Guiiem/TFG/01-Latex/Report/Glossary_file.tex

\glsxtrnewsymbol[description={Axial induction factor },unit={-}]{a}{$a$}
\glsxtrnewsymbol[description={Tangencial induction factor },unit={-}]{ap}{$a'$}
\glsxtrnewsymbol[description={Sectional drag coefficient},unit={-}]{Cd}{$C_d$}
\glsxtrnewsymbol[description={Sectional lift coefficient},unit={-}]{Cl}{$C_l$}
\glsxtrnewsymbol[description={Power coefficient},unit={-}]{Cp}{$C_P$}
\glsxtrnewsymbol[description={Torque coefficient},unit={-}]{Cq}{$C_Q$}
\glsxtrnewsymbol[description={Thrust coefficient},unit={-}]{Ct}{$C_T$}
\glsxtrnewsymbol[description={Coefficient of sectional blade element force normal to the rotor plane},unit={-}]{Cx}{$C_x$}
\glsxtrnewsymbol[description={Coefficient of sectional blade element force parallel to the rotor plane},unit={-}]{Cy}{$C_y$}
\glsxtrnewsymbol[description={Torque},unit={\si{\newton \meter}}]{Q}{\ensuremath{Q}}
\glsxtrnewsymbol[description={Local radius of the blades},unit={\si{\meter}}]{r}{\ensuremath{r}}
\glsxtrnewsymbol[description={Total radius of the blades},unit={\si{\meter}}]{R}{\ensuremath{R}}
\glsxtrnewsymbol[description={Wind speed},unit={\si{\meter \per \second}}]{Uinf}{$U_{\infty}$}

\glsxtrnewsymbol[description={},unit={ }]{Blank}{ }

\glsxtrnewsymbol[description={Angle of attack},unit={rad}]{Alpha}{$\alpha$}
\glsxtrnewsymbol[description={Angle of attack - optimal},unit={rad}]{AlphaOpt}{$\alpha_{opt}$}
\glsxtrnewsymbol[description={Angle of attack - stall},unit={rad}]{AlphaStall}{$\alpha_{s}$}

\glsxtrnewsymbol[description={Geometric twist plus pitch offset of the blades},unit={rad}]{beta}{$\beta$}

\glsxtrnewsymbol[description={Tip speed ratio},unit={-}]{Lambda}{$\lambda$}
\glsxtrnewsymbol[description={Tip speed ratio - local},unit={-}]{LambdaR}{$\lambda_r$}

\glsxtrnewsymbol[description={Air density},unit={\si{\kg \per \meter \cubed}}]{rho}{$\rho$}

\glsxtrnewsymbol[description={Local blade solidity},unit={-}]{bladesol}{$\sigma_r$}

\glsxtrnewsymbol[description={Adimensional local radius of the blades $r/R$},unit={-}]{Mu}{$\mu$}

\glsxtrnewsymbol[description={Geometric twist of the blades},unit={rad}]{tau}{$\tau$}

\glsxtrnewsymbol[description={Flow angle},unit={rad}]{phi}{$\phi$}

\glsxtrnewsymbol[description={Rotor speed},unit={\si{\radian \per \second}}]{Omega}{$\Omega$}

%\glsxtrnewsymbol[description={velocity},unit={\si{\metre\per\second}}]{v}{\ensuremath{v}}
%\glsxtrnewsymbol[description={acceleration},unit={\si{\metre\per\second\squared}}]{a}{\ensuremath{a}}
%\glsxtrnewsymbol[description={time},unit={\si{s}}]{t}{\ensuremath{t}}
%\glsxtrnewsymbol[description={force},unit={\si{N}}]{F}{\ensuremath{F}}
%\glsxtrnewsymbol[description={forasdasdasdce},unit={\si{N}}]{R}{\ensuremath{X_R}}

%ABCDEFGHIJKLMNOPQRSTUVWXYZ
