Guiiem/TFG/01-Latex/Report/TFG_Report.tex

\documentclass[11pt, a4paper, twoside]{book}

\usepackage[utf8]{inputenc}
\usepackage[T1]{fontenc} %Accents automàtics
\usepackage[english]{babel} %Language of the text
\usepackage[table]{xcolor}
\definecolor{lightgray}{gray}{0.9}
%Import the format package
\usepackage{Format}
\usepackage{placeins}
\usepackage{multirow}
\setcounter{secnumdepth}{5} %Level of depth in the numbering
\setcounter{tocdepth}{5}
\usepackage{xr}
\externaldocument{../Report_Attachment/TFG_Annex}

\usepackage[center]{caption}

\setlength\headheight{42pt} 

\setlength{\parindent}{0em}

\usepackage{pdflscape}
\usepackage{graphicx}
\usepackage{longtable}
\usepackage{adjustbox}

\usepackage{array}
\newcolumntype{L}[1]{>{\raggedright\let\newline\\\arraybackslash\hspace{0pt}}m{#1}}
\newcolumntype{C}[1]{>{\centering\let\newline\\\arraybackslash\hspace{0pt}}m{#1}}
\newcolumntype{R}[1]{>{\raggedleft\let\newline\\\arraybackslash\hspace{0pt}}m{#1}}

%% Headers in all the pagines
%% https://www.overleaf.com/learn/latex/Headers_and_footers
\usepackage{fancyhdr}
\pagestyle{fancy}
\renewcommand{\sectionmark}[1]{\markright{#1}}
\fancyhf{}
\rhead{\fancyplain{}\rightmark} %\Thesection?
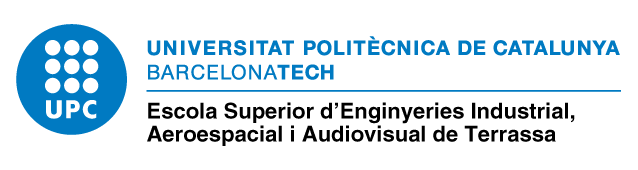
[picture p1: 01-Latex/Report/Logo_escola.png]
\lhead{} %Title?
\cfoot{\thepage}

\title{Glory template}
\author{Guillem Vergés i Plaza }
\date{October 2018}

\usepackage{afterpage}

\newcommand\blankpage{%
	\null
	\thispagestyle{empty}%
	\addtocounter{page}{-1}%
	\newpage}

\let\cleardoublepage=\clearpage

\usepackage{subfiles}

\usepackage{hyperref}
\usepackage{array}

\usepackage{svg}

\usepackage{siunitx}

%%\usepackage[colorlinks]{hyperref}
%\usepackage{glossaries-extra}
\usepackage[symbols,nogroupskip]{glossaries-extra}

% new keys must be defined before use

\glsaddstoragekey{unit}{}{\glsentryunit}
\glsnoexpandfields

\loadglsentries{Glossary_file}

\newglossarystyle{symbunitlong}{%
	\setglossarystyle{long3col}% base this style on the list style
	\renewenvironment{theglossary}{% Change the table type --> 3 columns
		\begin{longtable}{cp{\glsdescwidth}>{\centering\arraybackslash}p{2cm}}}%
		{\end{longtable}}%
	
	\renewcommand*{\glossaryheader}{%  Change the table header
		\bfseries Symbol & \bfseries Description & \bfseries Unit\\\hline
		\endhead}%
	\renewcommand*{\glossentry}[2]{%  Change the displayed items
		\glstarget{##1}{\glossentryname{##1}} %
		& \glossentrydesc{##1}% Description
		& \glsentryunit{##1}  \tabularnewline
	}%
}

\begin{document}

%%PORTADA---------------------------------------------------

\begin{titlepage}
\newcommand{\HRule}{\rule{\linewidth}{0.5mm}}
\center
\\[2cm]

\textsc{\Large Bachelor's Degree in Aerospace Technology Engineering}\\[0.5cm]
\textsc{\large Bachelor Thesis - Document: REPORT}\\[0.5cm]
\HRule \\[0.4cm]
{\Large \bfseries Project of designing and manufacturing a small wind turbine using fused deposition modeling technology }\\[0.1cm]
\HRule \\[2cm]
\large \emph{Director:}\\[0.5cm] 
%Table with the surnames alligned if necessary
Francesc Xavier \textsc{Sanz Cano}\\
[1cm]
\large \emph{Co-Director:}\\[0.5cm] 
%Table with the surnames alligned if necessary
Álvaro \textsc{Luna Alloza}\\
[1.5cm]
\large \emph{Autor:}\\[0.5cm] 
%Table with the surnames alligned if necessary
Guillem \textsc{Vergés i Plaza}\\
[1cm]
\vfill

\afterpage{\blankpage}

\begin{minipage}{0.4\textwidth}
\begin{flushleft} \large
\emph{Delivery date:}\\[0.2cm] 00-00-0000
\end{flushleft}
\end{minipage}
\begin{minipage}{0.4\textwidth}
\begin{flushright} \large
\emph{Presentation date:}\\[0.2cm] 28-10-2018
\end{flushright}
\end{minipage}
\end{titlepage}

%Define the size the pages will have
\newgeometry{inner=25mm,outer=25mm,top=35mm,bottom=30mm}

\section*{Abstract}

\newpage

\section*{Declaration of honour}

\newpage

\pagenumbering{arabic}

\tableofcontents
\listoffigures
\listoftables
\newpage

\printunsrtglossary[type=symbols,style=symbunitlong]

\chapter{Introduction}

	\section{Aim}
	
	\section{Scope}
	
	\section{Requirements}
	
	\section{Justification of the need}

\chapter{Development}

	\section{Background and review of the state of the art}
	
	\subfile{Development/State_of_the_art}
	
	\section{Approach and decision on possible solutions}
	\subfile{Development/Conceptual_design}

	\newpage
	\section{Electric design}
	\subfile{Development/ElectricDesign}

	\newpage
	\section{Aerodynamic design}
	\subfile{Development/AerodynamicDesign}
	
	\section{Structural design}
	\subfile{Development/StructuralDesign}

\chapter{Summary of the results}

\section{Budget summary}

\section{Analysis and assessment of the environmental implications}

\section{Future lines of work}

\section{Planning and programming of the next stage}

\section{Conclusions}

\bibliographystyle{ieeetran}
\raggedleft
\bibliography{TFG_Bibliography}

\end{document}
