Guiiem/TFG/01-Latex/Report/Development/StructuralDesign.tex

\documentclass[../TFG_Report.tex]{subfiles}
 
\begin{document}
	
\subsection{3D printing previous considerations}

\subsubsection{Printer characteristics}\label{Section_printer_character}

\subsubsection{Filament selection}

\subsection{Load cases}

\subsection{Link design and printing properties}

\end{document}
