Guiiem/TFG/06-Blade design/Aero/Iterations.ods

Iteration Number | 1st
Parameters
Individual members | 2000
Generations | 100
Crossover probability | 0.1
Maximum age | 20
Airfoil | 9-S1223
Reynolds | 3 | 120_200
Alpha | 50 | -12.5_12.5
Delta_alpha | 0.5
Airfoil cross section/c^2 | 0.0660 | Mesurat solidworks
Blade density | 430 | Estimat amb Cura
Blade elements per blade | 15
U cut in | 4
U rated | 10
TSR end starting | 4.608 | El optim directament
Min CP | 0 | pq min?
Maxim T starting | 200 | Default
TSR opt | 4.608 | Calculat
Radius | 0.8 | Calculat
Hub radius/r_tip | 0.38 | Hub de 30cm
Max chord | 1m | No limit
Min chord | 0 | No limit
Max twist | 90 | No limit
Min twist | -90 | No limit
J_gen | 0.006 | Dades gen
Resistive torque gen | 0
Factor to scale fitness for power | 0.7 | Default
Index of non dimnated blades | 1m | Default
Index of unfit blades | 1m | Default
Index on dominated blades | 2 | Default
Number of non dominated blades | 0 | Default
Number of unfit blades | 0 | Default
Number of dominated blades | 0 | Default
