Guiiem/TFG/06-Blade design/Aero/Power_curve_procedure_image.pdf

PMG selection | Airfoil selection | Blade geometry definition

[Not supported by viewer] [Not supported by viewer] [Not supported by viewer]

| Polars in 360º AoA range

Viterna extrapolation

Airfoil selection

[Not supported by viewer]

Blade Element Momentum Theory [Not supported by viewer]

ot supported by viewer]

[Not supported by viewer]

Intersection of both curves

Power curve<br>P = f(U)

[Not supported by viewer]

[Not supported by viewer]

[Not supported by viewer] [Not supported by viewe [Not supported by viewer] [Not supported by viewe [Not supported by viewer] [Not supported by viewe [Not supported by viewer] [Not supported by viewe [Not supported by viewer] [Not supported by viewe [Not supported by viewer] [Not supported by viewe [Not supported by viewer] [Not supported by viewe

[Not supported by viewer]

[Not supported by viewer]

[Not supported by viewer]

[Not supported by viewer]
