Guiiem/TFG/01-Latex/Report/Images/Aerodynamic_Design/First_AngleOfAttack_Analysis-eps-converted-to.pdf

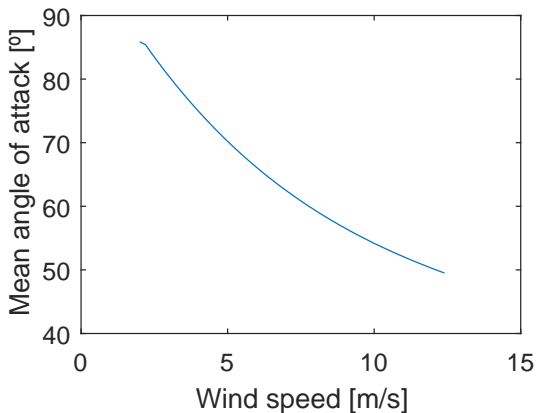
[picture p17: figure]
Wind speed [m/s]; Mean angle of attack [º]
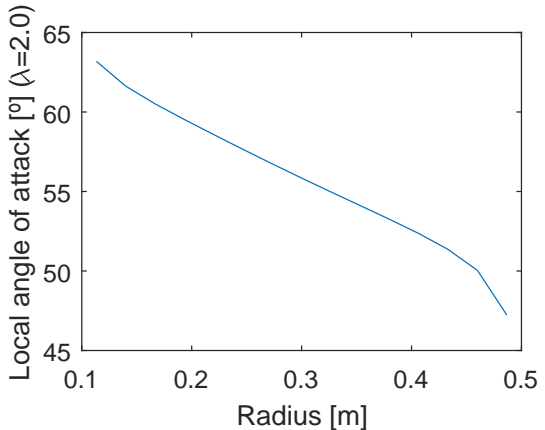
[picture p18: figure]
Radius [m]; Local angle of attack [º] ( =2.0)
