Guiiem/TFG/06-Blade design/Aero/1st iteration/SWT_Code/Read_Me_First.pdf

Running the Blade Optimisation programs

The m-file blade_opt_setup.m is configured to produce the data structure called ”data” that was used for the design example in Section7.4. To produce data, type in the command window

>> data=blade_opt_setup

and then to run the optimisation

>> blade_deopt(data)
