Guiiem/TFG/04-Airfoil selection/Imatges airfoils/2-SG6041.png

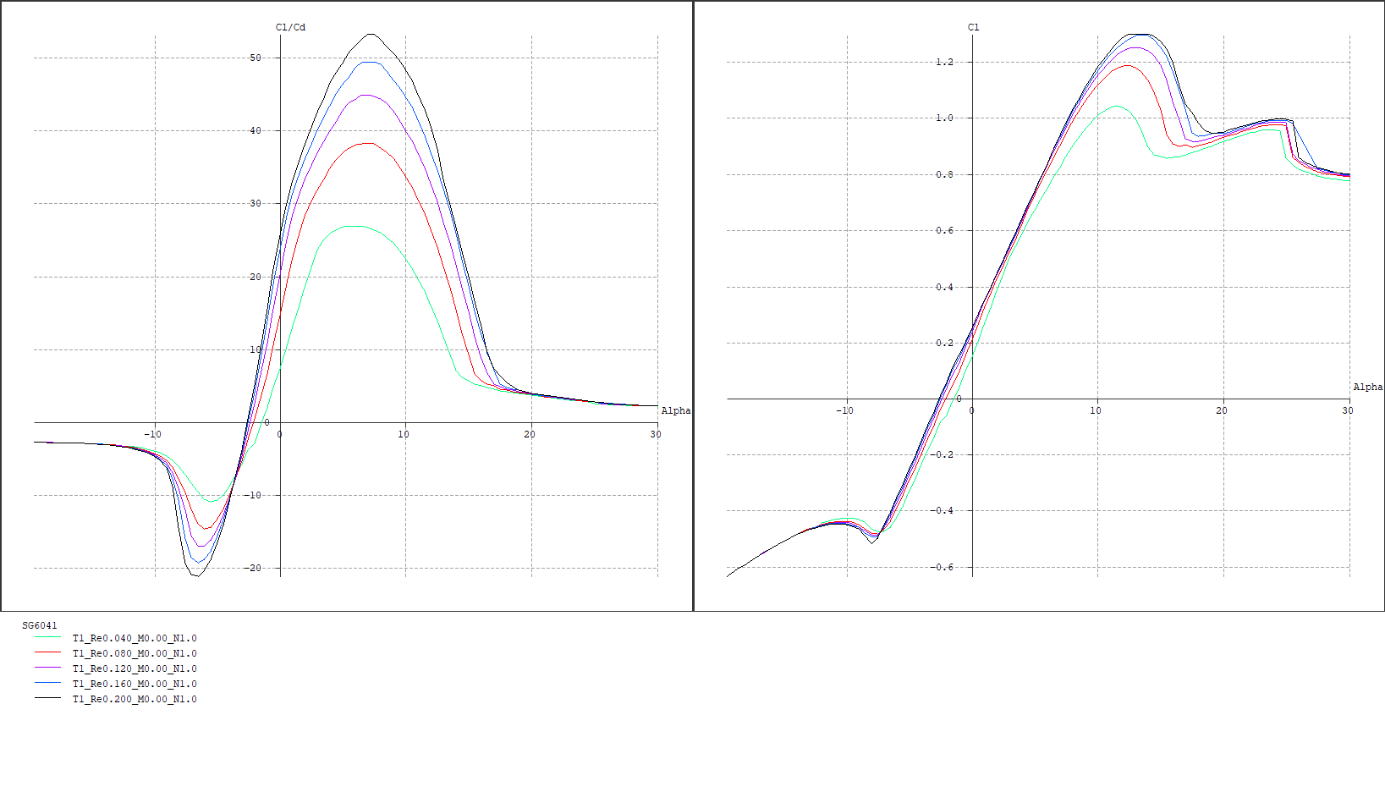
04-Airfoil selection/Imatges airfoils/2-SG6041.png
