Guiiem/TFG/04-Airfoil selection/Imatges airfoils/3-SG6042.png

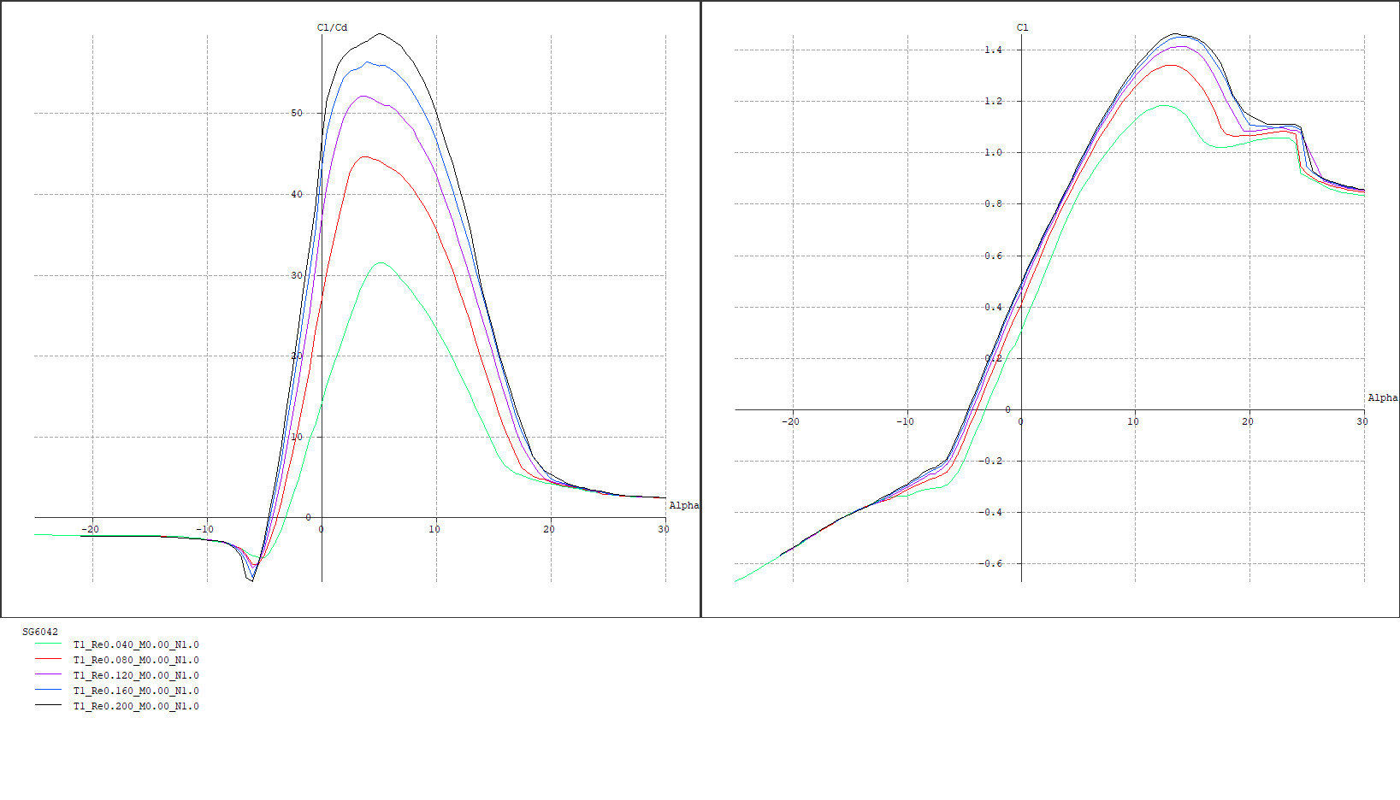
04-Airfoil selection/Imatges airfoils/3-SG6042.png
