Guiiem/TFG/04-Airfoil selection/Imatges airfoils/4-SG6043.png

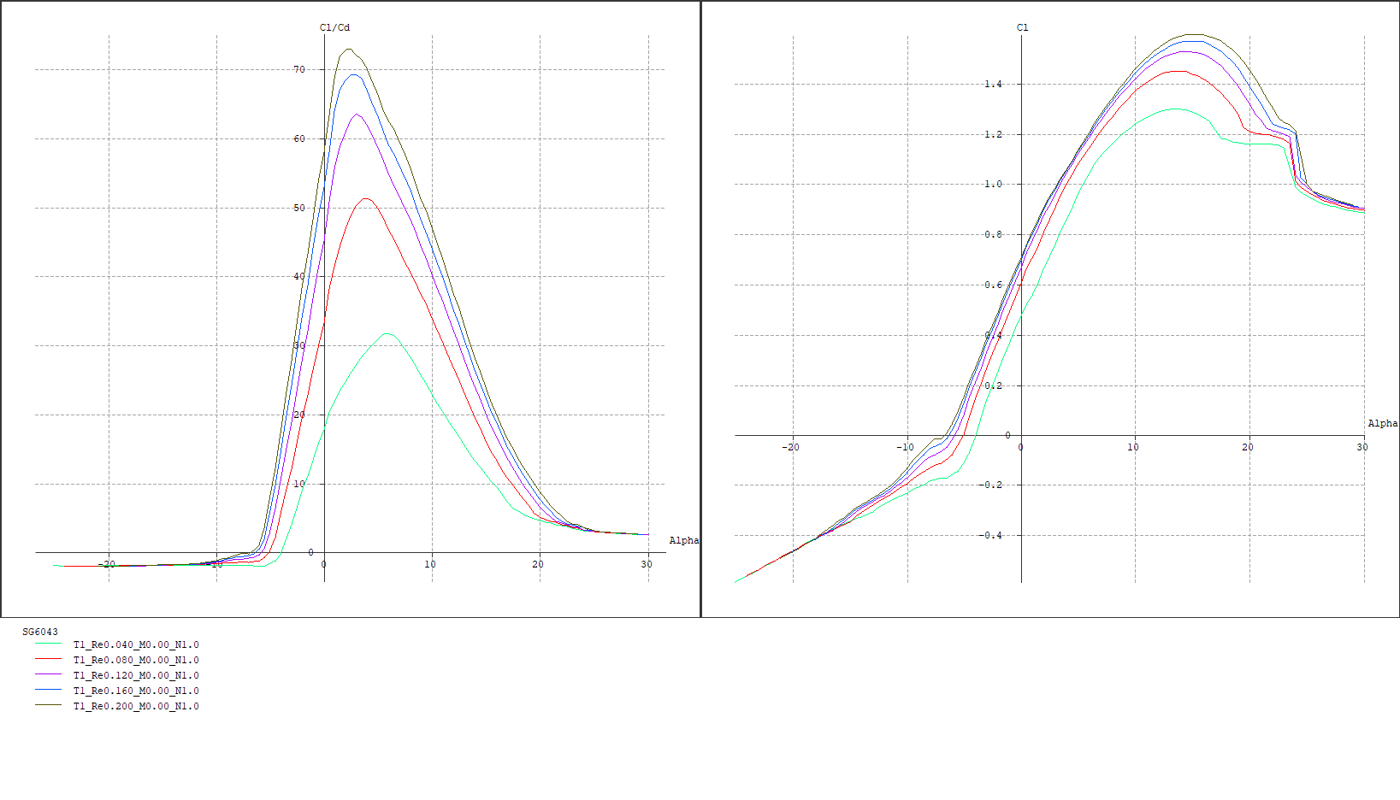
04-Airfoil selection/Imatges airfoils/4-SG6043.png
