Guiiem/TFG/04-Airfoil selection/Imatges airfoils/5-S833.png

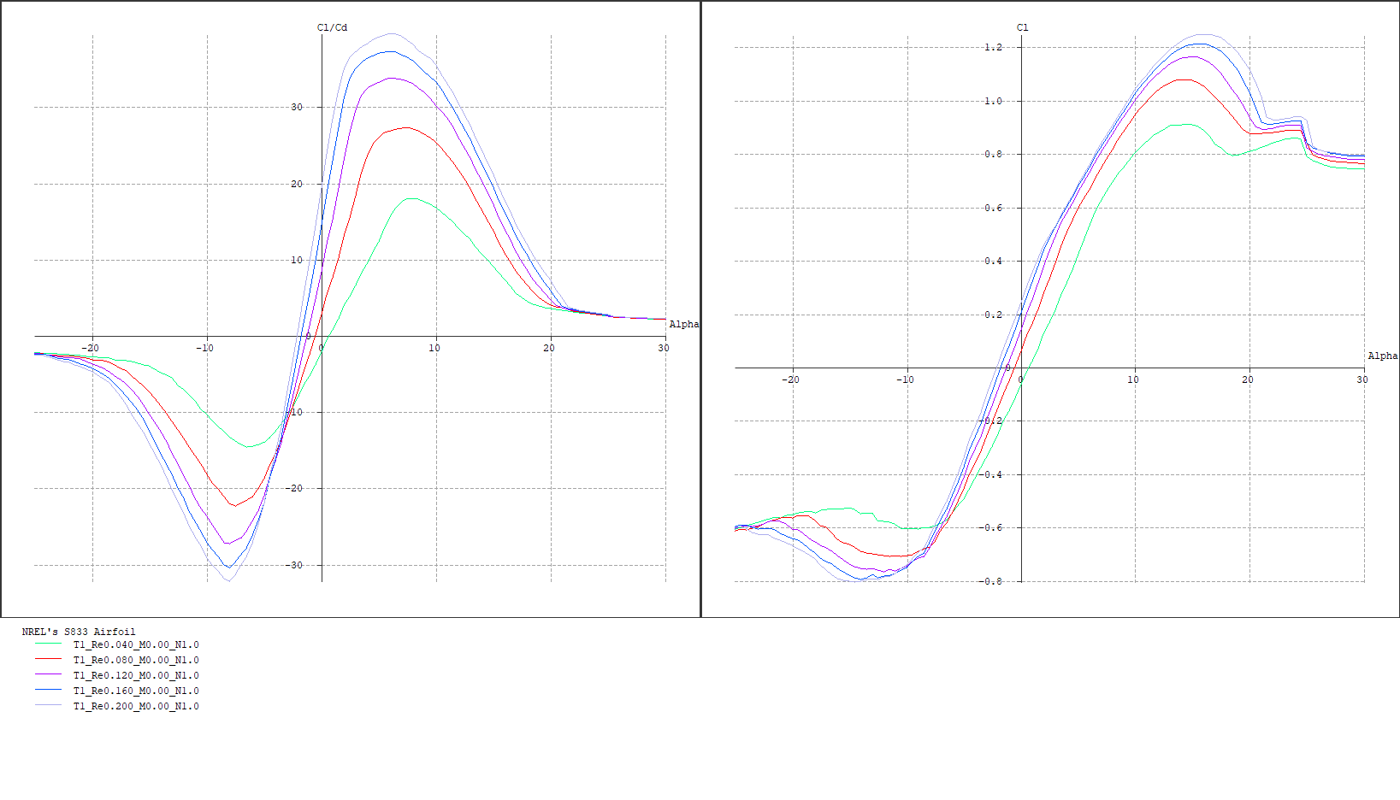
04-Airfoil selection/Imatges airfoils/5-S833.png
