Guiiem/TFG/04-Airfoil selection/Imatges airfoils/8-S1210.png

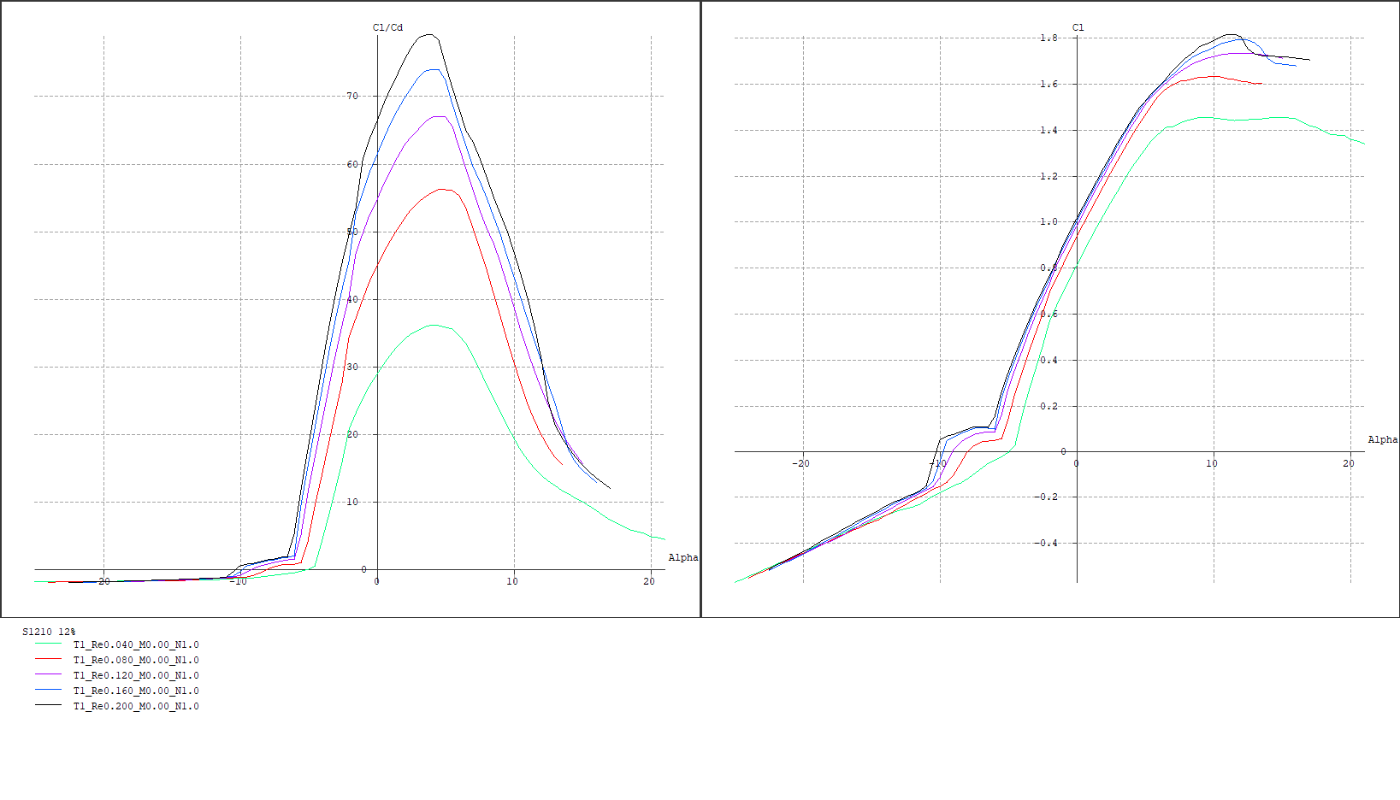
04-Airfoil selection/Imatges airfoils/8-S1210.png
