Guiiem/TFG/04-Airfoil selection/Imatges airfoils/9-S1223.png

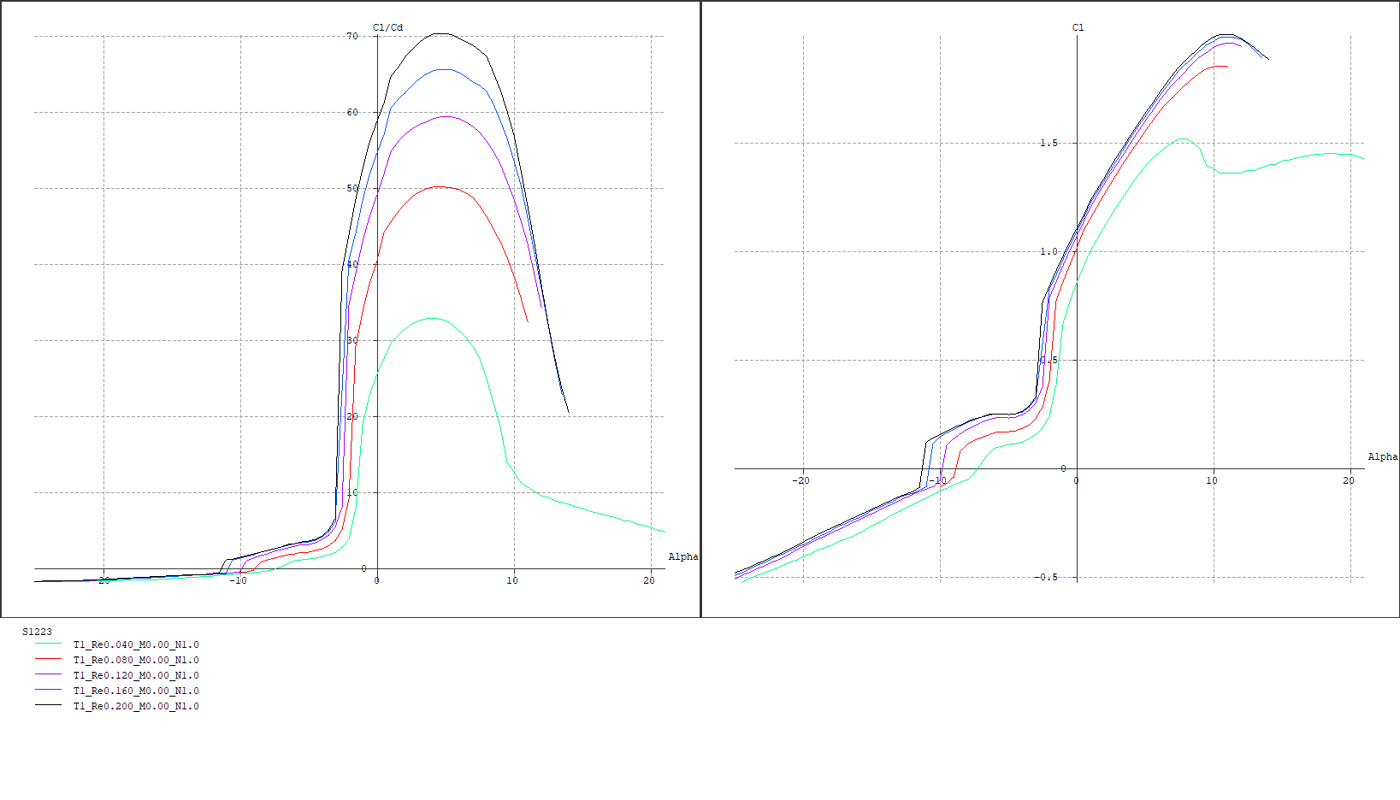
04-Airfoil selection/Imatges airfoils/9-S1223.png
