Guiiem/TFG/04-Airfoil selection/Imatges airfoils/10-S6063.png

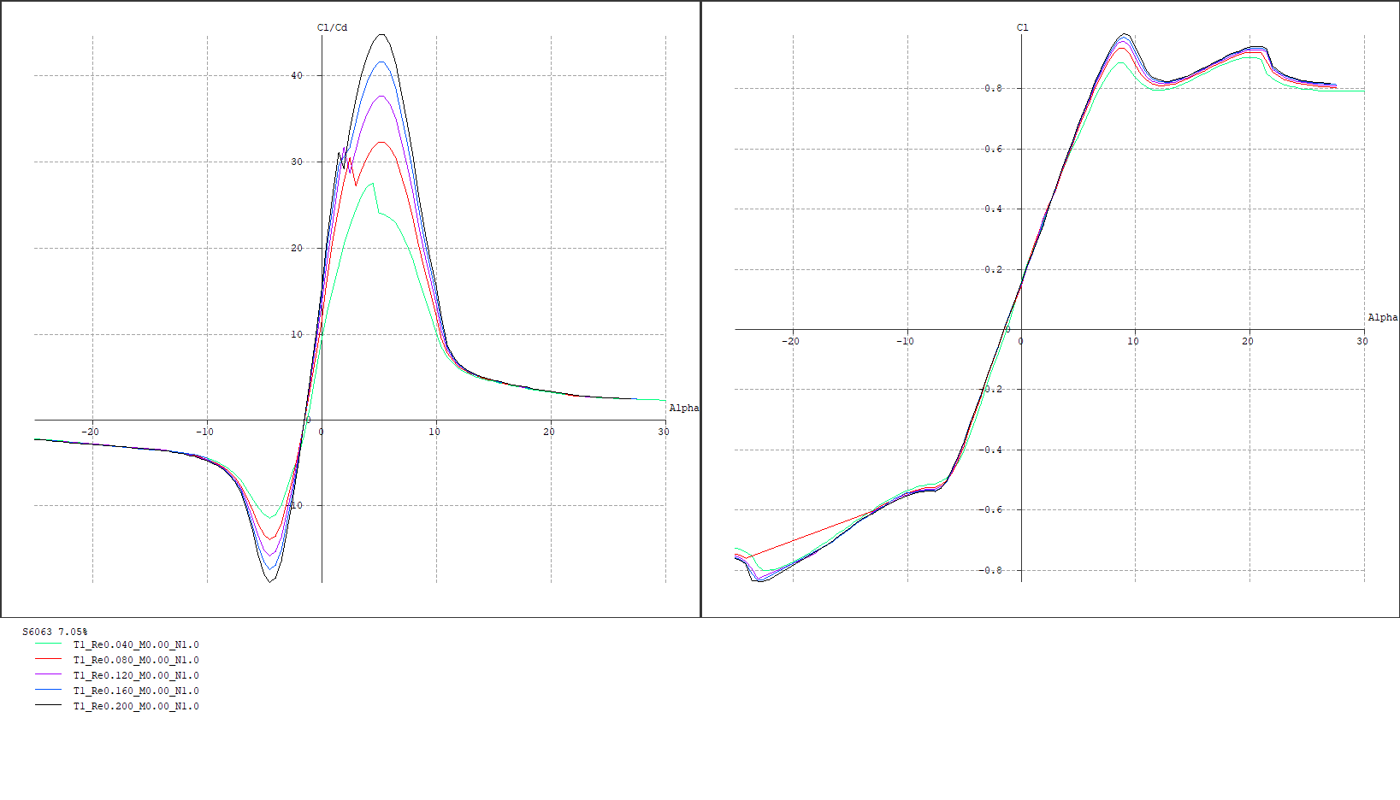
04-Airfoil selection/Imatges airfoils/10-S6063.png
