Guiiem/TFG/04-Airfoil selection/Imatges airfoils/11-S9037.png

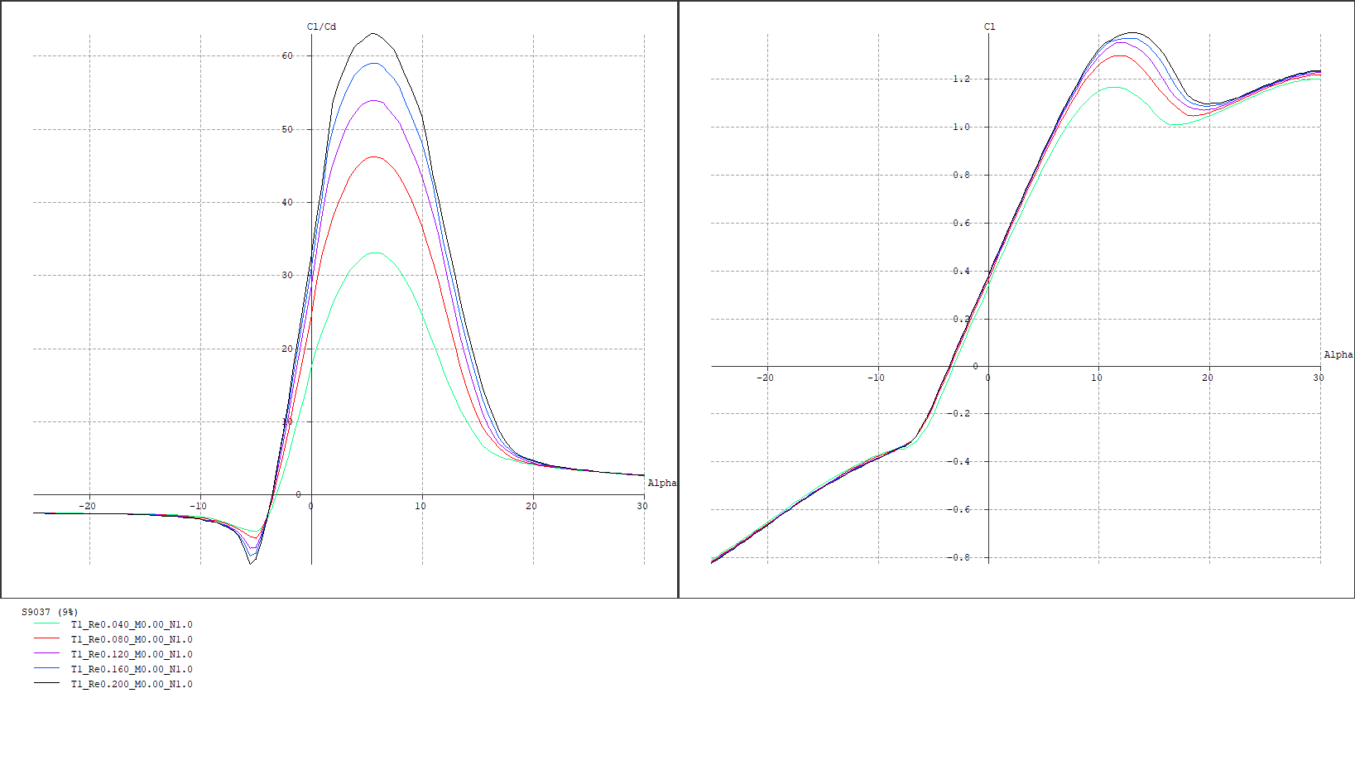
04-Airfoil selection/Imatges airfoils/11-S9037.png
