Guiiem/TFG/06-Blade design/Aero/Intersection_figure.jpg

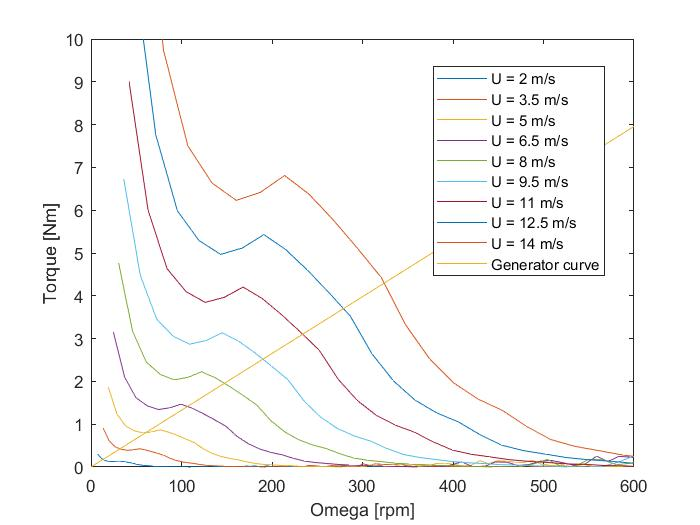
06-Blade design/Aero/Intersection_figure.jpg
