Guiiem/TFG/06-Blade design/Aero/Intersection_figure.png

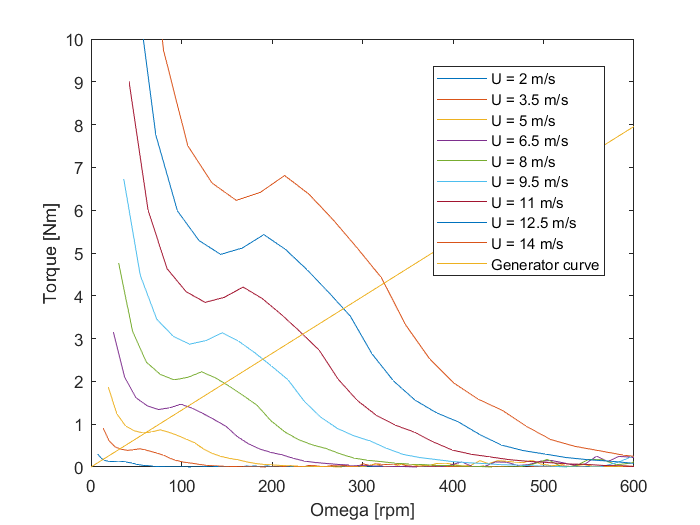
06-Blade design/Aero/Intersection_figure.png
