Guiiem/TFG/99-Other/Greek_alphabet.gif

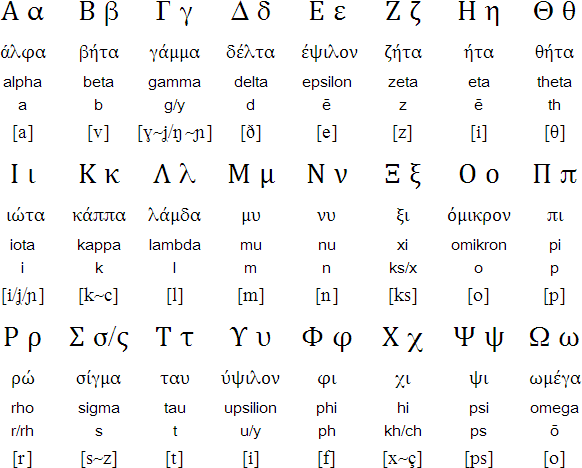
99-Other/Greek_alphabet.gif
