Guiiem/TFG/06-Blade design/Structural/SLM_LoadsCalculationExcel.xlsx

Spreadsheet for the Simple Load Model (SLM)
Australian Windpower 500 W turbine
Enter Input Data into Grey Cells Only |  |  |  | Parameters Calculated from Input Data |  |  |  | Loads from SLM |  |  |  |  | Enter Additional Data into Grey Cells Only |  |  |  | Calculation of the Equivalent Stresses |  | Partial Safety Factors (PSF) for SLM |  |  |  | Simple Load Model Results
Description | Input Value | Units | Symbol | Description | Value | Units | Symbol | Load Case A - Fatigue Loads on Blades and Rotor Shaft |  |  |  |  | Description | Value | Units | Symbol | Description | Equivalent Stress (MPa) | Description | PSF | Symbol |  | Load Case A - Fatigue Loads on Blades and Rotor Shaft
Air density | 1.2250 | kg/m^3 | r | Design Wind Speed | 8.40 | m/s | V_design | Equation | Description | SLM Value | Units | Symbol | Diameter of the Shaft | 0.025 | m |  | Load Case A - Fatigue Loads on Blades and Rotor Shaft |  | Partial Safety Factor for Fatigue Loads | 1.00 | g_f-f |  |  | Fatigue Damage Limit | Fatigue Damage | Conclusion
Gravitational acceleration | 9.8100 | m/s^2 | g | 50 year extreme wind speed | 42.00 | m/s | V_e50 |  | Blade Loads |  |  |  | Cross Sectional Area of the Shaft | 0.0004908738521 | m^2 | A_shaft | Blades | 2.51 | Partial Safety Factor for Ultimate Loading | 3.00 | g_f-u |  | Blades | 1.00 | 1.93012844e-06 | SAFE
Reference Wind Speed | 30.0000 | m/s | V_ref | 50yr extreme tip speed ratio | 0.75 | n/a | λ_e50 | 9.4 (IEC 21) | Centrifugal Force at the Blade Root (z-axis) | 631.65 | N | ΔF_zB | The second moment of inertia for the shaft | 1.917475985e-08 | m^4 | I_x-shaft | Shaft | 11.74 | Calculations for the material PSF (Enter Data into Grey Cells) |  |  |  | Shaft | 1.00 | Infinite Life | SAFE
Average Wind Speed | 6.0000 | m/s | V_ave | Design Tip Speed Ratio | 3.74 | n/a | λ_design | 9.5 (IEC 22) | Lead-lag Root Bending Moment (x-axis) | 5.97 | Nm | ΔM_xB | Section modulus for the shaft | 1.533980788e-06 | m^3 | W_shaft | Load Case B - Blade and Rotor Shaft Loads during Yaw |  |  |  |  |  | Load Case B - Blade and Rotor Shaft Loads during Yaw
Number of Blades | 3 | n/a | B | Drive Train Efficiency | 0.60 | n/a | ή | 9.6 (IEC 23) | Flapwise Root Bending Moment (y-axis) | 16.47 | Nm | ΔM_yB | Cross Sectional Area of the Blade Root | 0.00146 | m^2 | A_B | Blades | 0.21 | Description | Input | PSF | Symbol |  | Material Stress Limit (MPa) | Calculated Stress (MPa) | Conclusion
Blade Tip Radius | 0.5000 | m | R | Design Torque | 13.21 | Nm | Q_design |  | Shaft Loads |  |  |  | Ixx for the blade | 2.79e-08 | m^4 | I_xxB | Shaft | 31.72 | Enter "Y" for full characterisation of blade material, otherwise "N" | n |  |  | Blades | 13.33 | 0.21 | SAFE
Total Planform Area of the Blade | 0.2310 | m^2 | A_proj,B | Projected Area (turbine swept area) | 0.79 | m^2 | A_proj | 9.7 (IEC 24) | Thrust on shaft (x-axis) | 148.19 | N | ΔF_x-shaft | x-distance from blade centroid to the maximum stress point | 0.00919 | m | c_xB | Load Case C - Yaw Error Load on Blades |  | Blade Fatigue strength partial safety factor | --> | 10 | g_mB-f | Shaft | 27.78 | 31.72 | FAIL
Drag Coefficient of the Blades | 1.5000 | n/a | C_d | Design Rotational Speed of the Rotor | 62.83 | rad/s | w_n,design | 9.8 (IEC 25) | Shaft Moment about x-axis | 13.31 | Nm | ΔM_x-shaft | Iyy for the blade | 1.199e-06 | m^4 | I_yyB | Blades | 0.32 | Blade Ultimate strength partial safety factor | --> | 3 | g_mB-u | Load Case C - Yaw Error Load on Blades
Max Lift Coefficient of the Blades | 2.0000 | n/a | C_l,max | Maximum Possible Rotor Speed | 62.83 | rad/s | w_n,max | 9.9 (IEC 26) | Shaft Moment | 13.37 | Nm | ΔM_shaft | y-distance from blade centroid to the maximum stress point | 0.00778 | m | c_yB | Load Case D - Maximum Thrust on Shaft |  |  |  |  |  |  | Material Stress Limit (MPa) | Calculated Stress (MPa) | Conclusion
Thrust Coefficient | 0.5000 | n/a | C_T | Max Yaw Rate | 3.00 | rad/s | w_yaw,max | Load Case B - Blade and Rotor Shaft Loads during Yaw |  |  |  |  | Blade x-section modulus | 3.035908596e-06 | m^3 | W_xB | Shaft | 0.11 | Enter "Y" for full characterisation of shaft material, otherwise "N" | n |  |  | Blades | 13.33 | 0.32 | SAFE
Maximum Rotor Speed | 600.0000 | rpm | n_max | 50yr extreme tip speed ratio | 0.75 | n/a | λ_e50 | Equation | Description | SLM Value | Units | Symbol | Blade y-section modulus | 0.0001541131105 | m^3 | W_yB | Load Case E - Maximum Rotational Speed |  | Shaft Fatigue strength partial safety factor | --> | 10 | g_m-shaft-f | Load Case D - Maximum Thrust on Shaft
Design Rotor Speed | 600.0000 | rpm | n_design | Ecentricity of the Rotor Centre of Mass | 0.0025 | m | e_r | 9.16 (IEC 28) | Flapwise Root Bending Moment (y-axis) | 32.25 | Nm | M_yB | Ultimate Material Strength for the Blades | 120 | MPa | f_kB | Blades | 0.22 | Shaft Ultimate strength partial safety factor | --> | 3 | g_m-shaft-u |  | Material Stress Limit (MPa) | Calculated Stress (MPa) | Conclusion
Second Moment of Inertia for each Blade | 0.0633 | kgm^2 | I_B | Effective brake torque | 0.00 | Nm | M_brake | 9.11,12 (IEC 29,30) | Bending moment on the shaft | 48.65 | Nm | M_shaft | Ultimate Material Strength for the Shaft | 250 | MPa | f_k-shaft | Shaft | 0.67 | Material Strengths (with Factors of Safety) |  |  |  | Shaft | 13.33 | 0.11 | SAFE
Single Blade Mass | 0.4000 | kg | m_B |  |  |  |  | Load Case C - Yaw Error Load on Blades |  |  |  |  | Enter Additional Data for Fatigue Calculations into Yellow Cells |  |  |  | Load Case F - Short at Load Connection |  |  |  |  |  | Load Case E - Maximum Rotational Speed
Rotor Mass (All Blades plus Hub) | 2.0000 | kg | m_r |  |  |  |  | Equation | Description | SLM Value | Units | Symbol |  |  |  |  | Blades | 2.90 | Description | Value | Units |  |  | Material Stress Limit (MPa) | Calculated Stress (MPa) | Conclusion
Distance from Blade centre of gravity to rotor axis | 0.2000 | m | R_cog |  |  |  |  | 9.13 (IEC 31) | Flapwise Root Bending Moment (y-axis) | 49.85 | Nm | M_yB | Description | Value | Units | Symbol | Shaft | 14.91 | Ultimate Strength for Blade Material (IEC 47) | 13.33 | MPa |  | Blades | 13.33 | 0.67 | SAFE
Distance Between Rotor Centre and First Bearing | 0.0260 | m | L_rb |  |  |  |  | Load Case D - Maximum Thrust on Shaft |  |  |  |  | Design life of the turbine | 20 | Years |  | Load Case G - Shutdown Braking |  | Ultimate Strength for Shaft Material | 27.78 | MPa |  | Shaft | 27.78 | 0.22 | SAFE
Distance Between the Rotor Centre and the yaw axis | 0.2180 | m | L_rt |  |  |  |  | Equation | Description | SLM Value | Units | Symbol |  | 631152000 | s | T_d | Blades | n/a | Calculations for Fatigue (Enter Data into Grey Cells) |  |  |  | Load Case F - Short at Load Connection
Gearbox Ratio (enter 1.0 for no gearbox) | 1.0000 | n/a | Gear |  |  |  |  | 9.14 (IEC 32) | Maximum Thrust on Shaft | 54.12 | N | F_x-shaft | Number of Fatigue Cycles | 18934560000 | n/a | n_i | Shaft | n/a |  |  |  |  |  | Material Stress Limit (MPa) | Calculated Stress (MPa) | Conclusion
Enter "Y" if brake is on high speed side of gearbox, otherwise "N" | N | n/a | n/a |  |  |  |  | Load Case E - Maximum Rotational Speed |  |  |  |  | Number of Cycles to Failure as a Function of Stress (Shaft) | 10000000000 | n/a | N_shaft | Load Case H - Parked Wind Loads during Idling |  | Description | Value | Units | Symbol | Blades | 13.33 | 2.90 | SAFE
Brake torque (enter 0.0 for no brake) | 0.0000 | Nm | M_brake |  |  |  |  | Equation | Description | SLM Value | Units | Symbol | Number of Cycles to Failure as a Function of Stress (Blade) | 12300000000000 | n/a | N_blade | Blades | 0.61 | Blade Stress Level | 2.51 | MPa | s_iB | Shaft | 27.78 | 14.91 | SAFE
Design Power | 0.5000 | kW | P_design |  |  |  |  | 9.15 (IEC 33) | Centrifugal Force at the Blade Root (z-axis) | 315.83 | N | F_zB |  |  |  |  | Shaft | 2.29 | Associated Blade Stress Level | 25.07 | MPa |  | Load Case G - Shutdown Braking
Short Circuit Torque Factor | 2.0000 | n/a | G |  |  |  |  | 9.16 (IEC 34) | Bending Moment on the shaft | 1.02 | Nm | M_shaft |  |  |  |  |  |  | Number of Cycles to Failure at this Stress | 9810000000000000 | - | N_B |  | Material Stress Limit (MPa) | Calculated Stress (MPa) | Conclusion
Type "Y" if blades are stationary during parking, otherwise "N" | Y | n/a | n/a |  |  |  |  | Load Case F - Short at Load Connection |  |  |  |  |  |  |  |  |  |  | Shaft Stress Level | 11.74 | MPa | s_i-shaft | Blades | 13.33 | n/a | n/a
 |  |  |  |  |  |  |  | Equation | Description | SLM Value | Units | Symbol |  |  |  |  |  |  | Associated Shaft Stress Level | 117.37 | MPa | - | Shaft | 27.78 | n/a | n/a
 |  |  |  |  |  |  |  | 9.17 (IEC 35) | Bending Moment on Shaft | 26.42 | Nm | M_x-shaft |  |  |  |  |  |  | Number of Cycles to Failure at this Stress | inf | - | N_shaft | Load Case H - Parked Wind Loads during Idling
 |  |  |  |  |  |  |  | 9.18 (IEC 36) | Lead-lag Root Bending Moment (x-axis) | 8.81 | Nm | M_xB |  |  |  |  |  |  |  |  |  |  |  | Material Stress Limit (MPa) | Calculated Stress (MPa) | Conclusion
 |  |  |  |  |  |  |  | Load Case G - Shutdown Braking |  |  |  |  |  |  |  |  |  |  |  |  |  |  | Blades | 13.33 | 2.29 | SAFE
 |  |  |  |  |  |  |  | Equation | Description | SLM Value | Units | Symbol |  |  |  |  |  |  |  |  |  |  | Shaft | 27.78 | 0.61 | SAFE
 |  |  |  |  |  |  |  | 9.19 (IEC 37) | Bending Moment on Shaft | n/a | Nm | M_x-shaft
 |  |  |  |  |  |  |  | 9.20 (IEC 38) | Lead-lag Root Bending Moment (x-axis) | n/a | Nm | M_xB
 |  |  |  |  |  |  |  | Load Case H - Parked Wind Loads during Idling
 |  |  |  |  |  |  |  | Equation | Description | SLM Value | Units | Symbol
 |  |  |  |  |  |  |  | 9.23,24 (IEC 39,40) | Flapwise Root Bending Moment (y-axis) | 93.59 | Nm | M_yB
 |  |  |  |  |  |  |  | 9.25,26 (IEC 41,42) | Maximum Thrust on Shaft | 1123.13 | N | F_x-shaft
