Guiiem/TFG/Budget.ods

Concept | Reseller | Usage | Unitary Price | Quantity | Total Price | Total Invested
Mordaza En C Maxsteel 75mm Stanley 0-83-033 | Servei Estació | Join pieces togheter when gluing | 5.85 € | 1 | 5.85 € | 43.35 €
Barra Roscada Cincada M6 330mm | Servei Estació | Wind tunnel tests | 4.10 € | 1 | 4.10 €
Pinzas Medianas 9 cm 4 Unid | Servei Estació | Join pieces togheter when gluing | 5.95 € | 1 | 5.95 €
Mtn Imprimación Plasticos y Metales | Servei Estació | Primer for paining the blades | 8.50 € | 1 | 8.50 €
Aradit Standard 5+5ml | Servei Estació | Epoxi to join pieces together | 6.45 € | 1 | 6.45 €
Spray Al Agua Blanco Birllo 9010 350 ml. | Servei Estació | Paint for painting the blades | 12.50 € | 1 | 12.50 €
