Guiiem/TFG/05-State of the art/SoA.ods

Manufacturer | Model | Architecture | Number of blades | Rotor diameter [m] | RPM | Nominal wind speed [m/s] | Nominal power [W] | Material | Control system | Generator | Weight [kg]
Bornay | 13 | HAWT, Upwind, self regulating | 2 | 2.86 | @600 | 12 | 1500 | Carbon/glass fiber | Electronic regulator and pasive by inclination | Trifasic with permanent Neodymium magnets | 41 | https://www.bornay.com/es/productos/aerogeneradores/wind-plus
Bornay | Bee 800 | HAWT, Upwind, self regulating | 5 | 1.75 | @500 | 12 | 800 | Injected nylon | Electronic controller | Trifasic with permanent Neodymium magnets | 29 | web bornay tb
Enair | E30 PRO | HAWT, Upwind, self regulating | 3 | 3.80 | 250 | 11 | 1900 | Glass fiber | Passive pitch control with two action speeds | Neodymium permanent magets (30 poles) | 125 | https://www.enair.es/es/aerogeneradores/e30pro
SD Wind Energy | SD3 | HAWT, Downwind, self regulating | 3 | 3.90 | Màx 300 | - | 3000* | Glass Thermoplastic Composite | Passive | Brushless permanent magnets | - | https://sd-windenergy.com/small-wind-turbines/sd3-3kw-wind-turbine/
Smarttwister | ST-1000 | VAWT, Helicoidal blade | 1 | 0.34 (1.38m height) | 525 | 7.6 | 1000 | Technic nylon | Electronic controller | Neodymium permanent magnets | 34 | http://www.smarttwister.org/index.php/es/aerogeneradores/aerogenerador-st-1000#descargas
Aeolos | V 300W | VAWT | 3 | 1.20 (1.60m height) | 300 | 10 | 300 | Aluminum alloy | - | Permanent magnets | 10 | http://www.windturbinestar.com/300w-vertical-wind-turbine.html
Bergey | Excel 1 | HAWT, Upwind | 3 | 2.50 | - | 11 | 1000 | Glass fieber | Furling against high wind speeds | Neodymium permanent magets | 34 | http://bergey.com/products/wind-turbines/bergey-excel-1
Rutland | 1200 | HAWT, Upwind | 3 | 1.22 | - | 15 | 483 | - | Electronic controller | - | 11 | https://www.emarineinc.com/Shared/pdf/Rutland/Rutland_1200_Brochure.pdf
AutoMaxx | DB-400 | HAWT, Upwind | 3 | 1.22 | - | 13 | 400 | Nylon and glass fiber | Electronic controller | Brushless permanent magnets | 10 | https://autowindmill.weebly.com/windmill.html
MarsRock | 400W Economy Windmill | HAWT, Upwind | 3 | 1.40 | 400 | 13 | 400 | Nylon and glass fiber | Electronic controller | Trifasic with permanent magnets | 10 | https://www.amazon.com/MarsRock-Turbine-Generator-Economy-Windmill/dp/B077GS8Q4Z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
 |  |  |  |  |  |  |  |  | All direct drive
 |  |  |  |  |  |  |  |  | The most of the electronic controllers have a braking device protection
