Guiiem/TFG/08-Electrical system/Generator selection/Generator_Selection_Options.ods

Option | Manufacturer | Model | Rated Power | Max Power | Rated Speed | Rated Torque | Starting Torque | Weight | Price | Shipping | Total
 |  |  | [W] | [W] | [rpm] | [Nm] | [Nm] | [Kg] | [€] | [€] | [€]
1 | Shangai Laisa New Energy Technology | LS-500w | 500 | 536 | 600 | 7.96 | 0.42 | 6.1 | 113 | 122 | 235 | LIKELY
2 | China Top Grand | TGET220 | 500 |  | 500 | 9.55 | <0.1 | 8 |  |  |  | REQUEST QUOTATION
3 | Qingdao Greef New Energy | GDG-320 | 500 | 620 | 200 | 23.87 | <0.1 | 20 | 702 | 0 | 702 | NOPE
4 | Qingdao HenryD Wind Power Equipment | 500W | 500 | 750 | 500 | 9.55 | 0.4 | 12.5 | 162 |  |  | MAYBE
5 | Mecc Alte | Eogen 30/16 | 500 |  | 415 | 11.51 |  | 21.2 |  |  |  | Pesa massa
6 | Ningbo Ginlong Technologies | GL-PMG-500A | 500 |  | 450 | 10.61 | <0.5 | 14.4
