Guiiem/TFG/03-Anemometer/Coberta_motor.SLDPRT

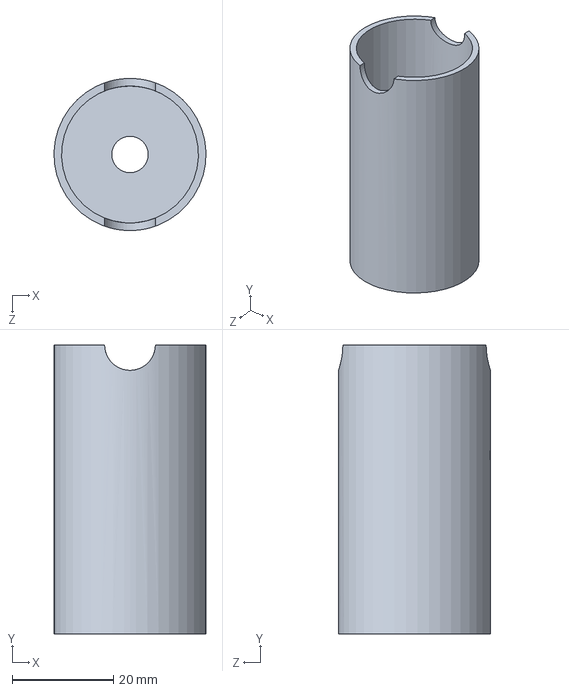
[picture p30: CAD file, 2019-05-20]
03-Anemometer/Coberta_motor.SLDPRT
30.0 x 57.0 x 30.0 mm
