Guiiem/TFG/07-Hub/3_Hub.SLDPRT

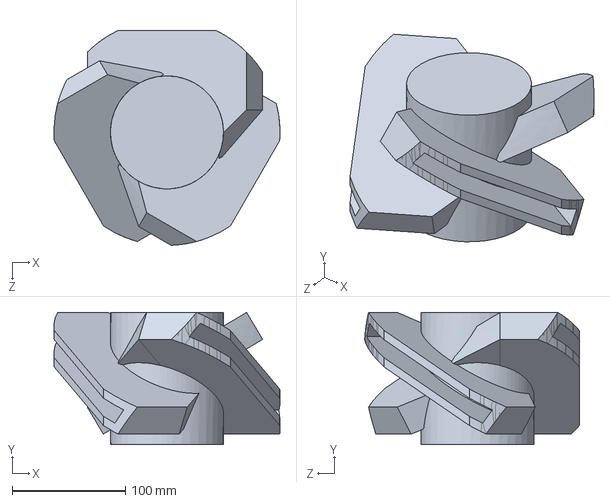
[picture p31: CAD file, 2019-09-13]
07-Hub/3_Hub.SLDPRT
199.9 x 116.9 x 189.9 mm
