Guiiem/TFG/99-Other/Proves/Mesura_densitat_20_06_19.SLDPRT

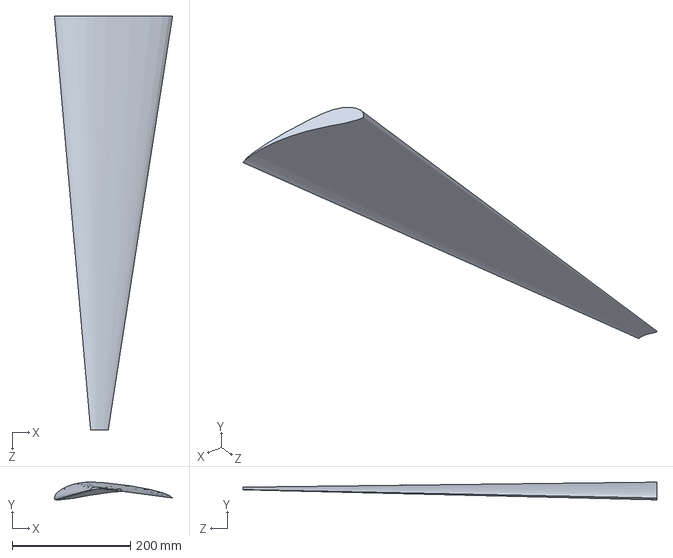
[picture p32: CAD file, 2019-07-02]
99-Other/Proves/Mesura_densitat_20_06_19.SLDPRT
200.0 x 30.1 x 700.0 mm
