Guiiem/TFG/03-Anemometer/3_Base_pales.SLDPRT

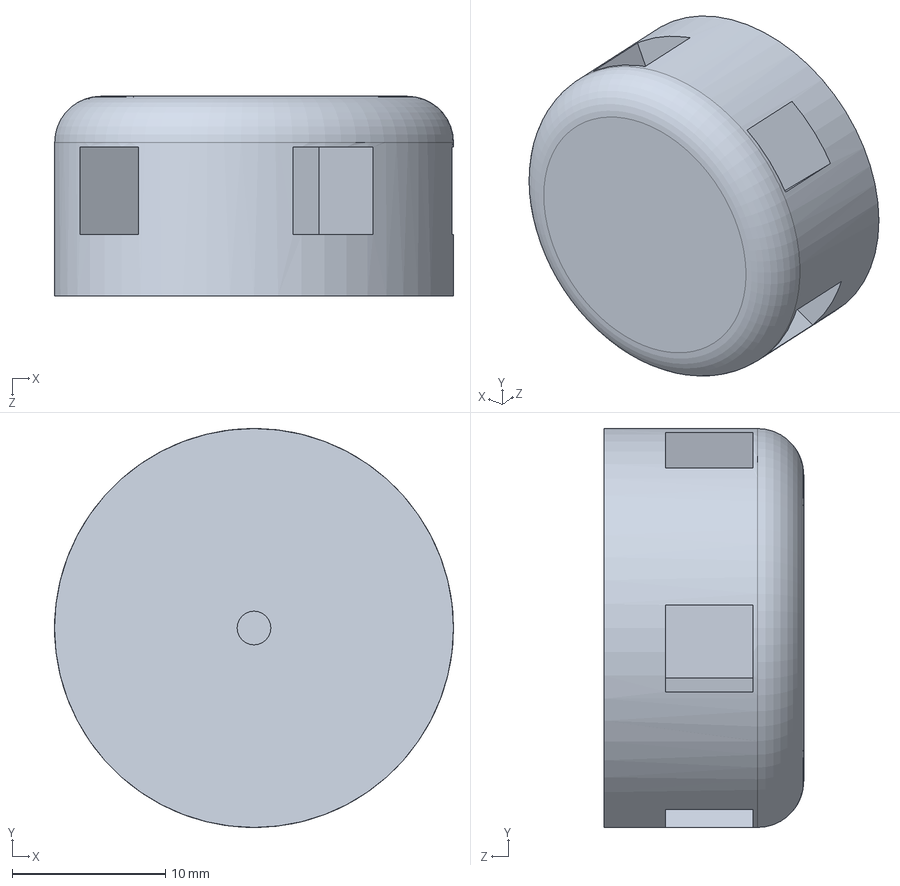
[picture p33: CAD file, 2019-05-20]
03-Anemometer/3_Base_pales.SLDPRT
26.0 x 26.0 x 13.0 mm
