Guiiem/TFG/07-Hub/2_Hub.SLDPRT

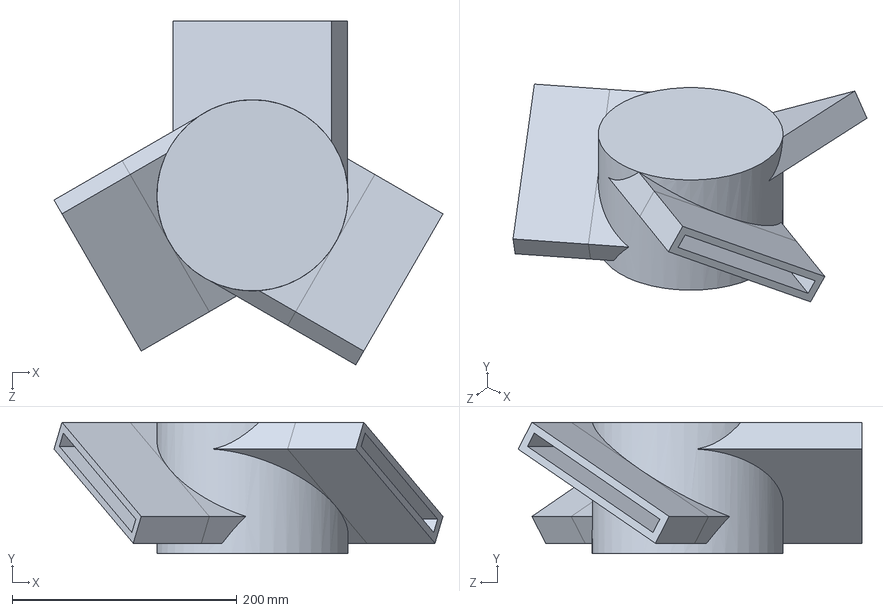
[picture p34: CAD file, 2019-09-13]
07-Hub/2_Hub.SLDPRT
346.1 x 116.9 x 305.8 mm
