Guiiem/TFG/03-Anemometer/2_Base_pales.SLDPRT

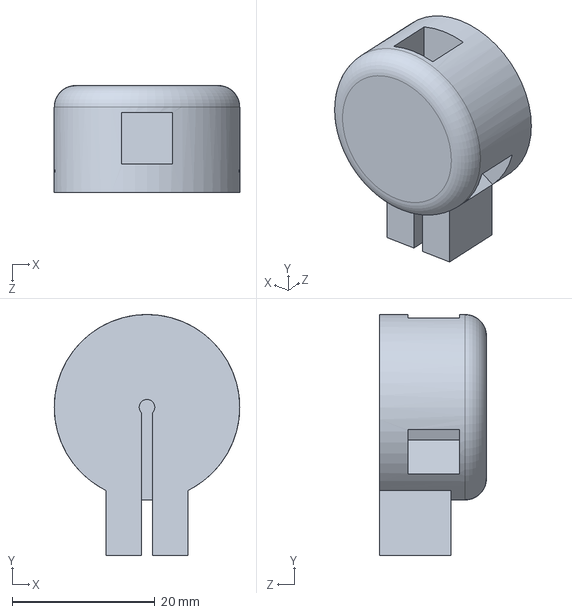
[picture p35: CAD file, 2019-05-20]
03-Anemometer/2_Base_pales.SLDPRT
26.0 x 33.8 x 15.0 mm
