Guiiem/TFG/07-Hub/1_Hub.SLDPRT

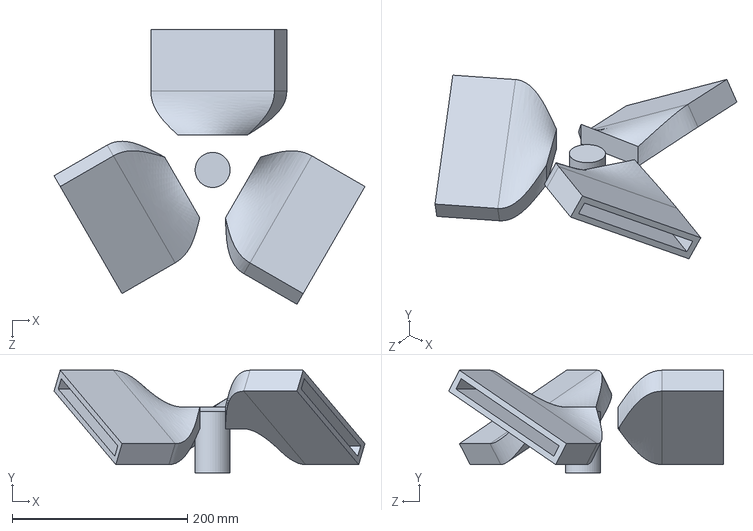
[picture p36: CAD file, 2019-09-13]
07-Hub/1_Hub.SLDPRT
354.7 x 116.9 x 313.3 mm
