Guiiem/TFG/03-Anemometer/Pala_anemometre.SLDPRT

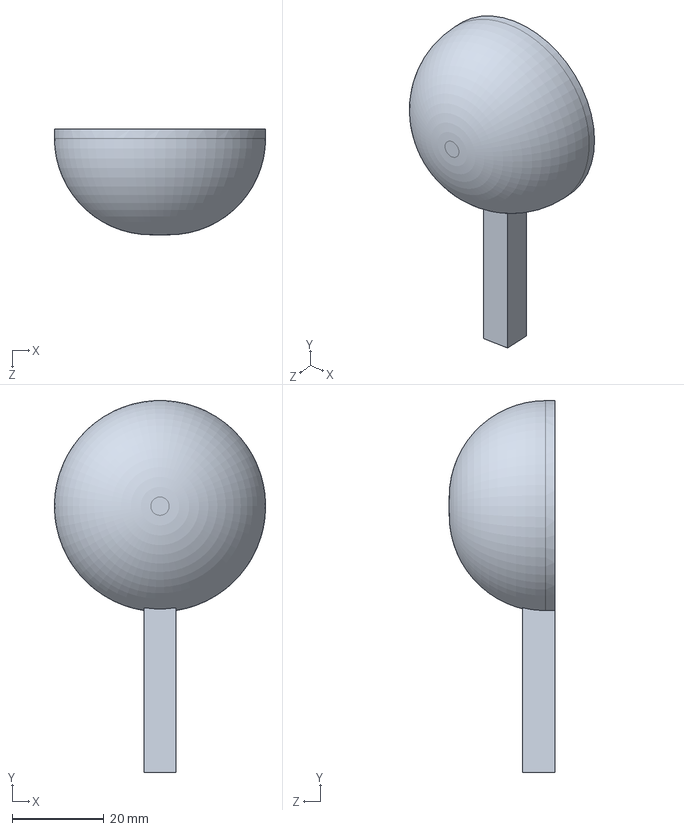
[picture p37: CAD file, 2019-05-20]
03-Anemometer/Pala_anemometre.SLDPRT
46.0 x 81.0 x 23.0 mm
