Guiiem/TFG/07-Hub/3_Hub_stl_NonFinished_29_7_2019.STL

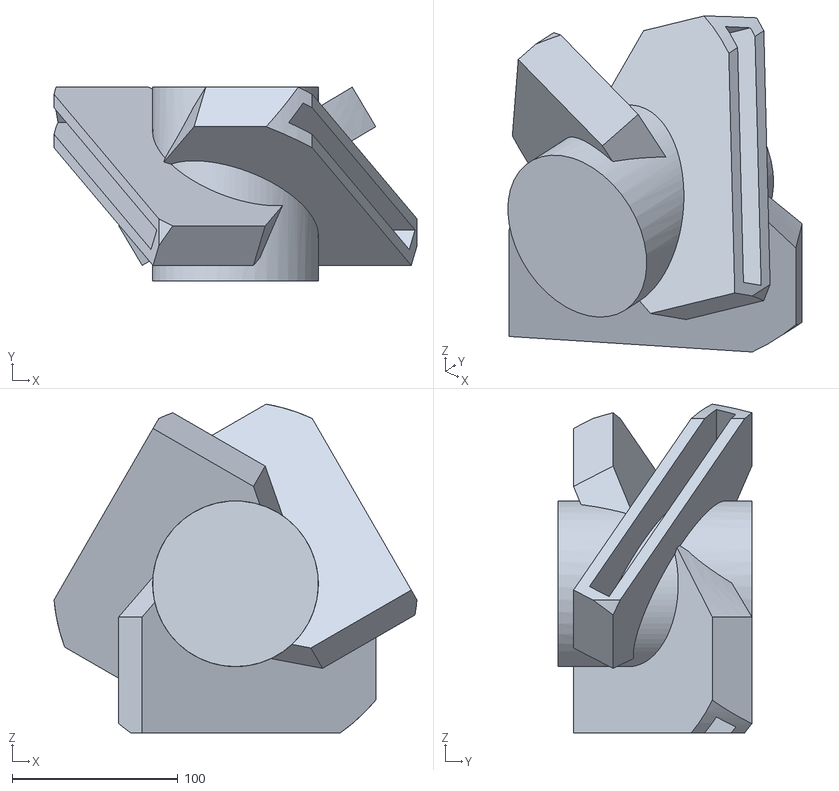
[picture p38: CAD file, 2019-09-13]
07-Hub/3_Hub_stl_NonFinished_29_7_2019.STL
219.1 x 116.9 x 198.4
