Guiiem/TFG/03-Anemometer/2_Coberta_motor.SLDPRT

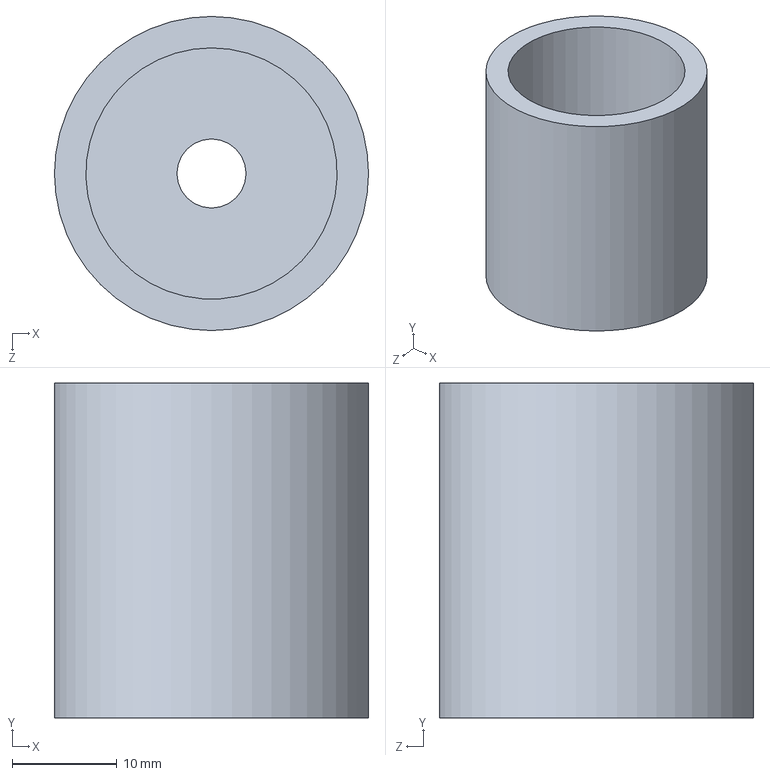
[picture p39: CAD file, 2019-05-20]
03-Anemometer/2_Coberta_motor.SLDPRT
30.0 x 32.0 x 30.0 mm
