Guiiem/TFG/03-Anemometer/Base_pales.SLDPRT

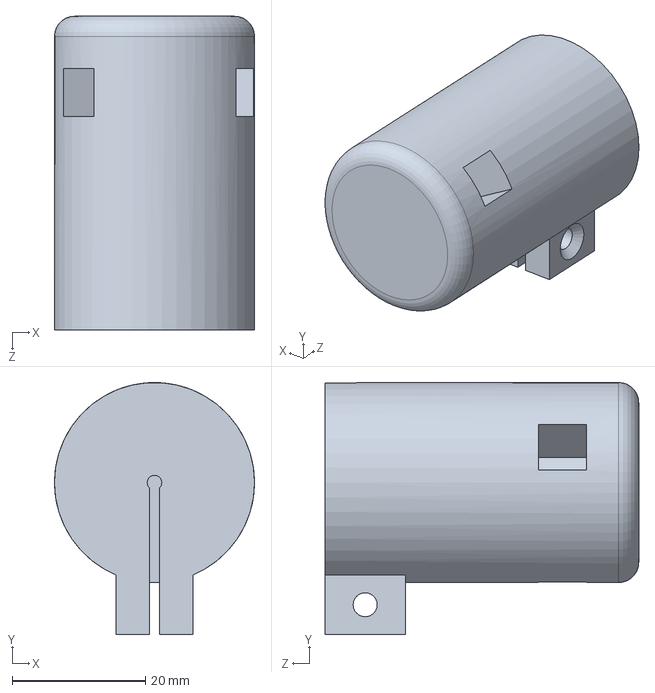
[picture p40: CAD file, 2019-05-20]
03-Anemometer/Base_pales.SLDPRT
30.0 x 37.8 x 47.0 mm
