Guiiem/TFG/(list of files, cad)

Other CAD files:
03-Anemometer/2_Pala_anemometre.SLDPRT
03-Anemometer/2_Base_pales.STL
03-Anemometer/2_Coberta_motor.STL
03-Anemometer/2_Pala_anemometre.STL
03-Anemometer/3_Base_pales.STL
03-Anemometer/Base_pales.STL
03-Anemometer/Coberta_motor.STL
03-Anemometer/Pala_anemometre.STL
99-Other/Proves/Mesura_densitat_20_06_19.STL
