Guiiem/TFG/06-Blade design/Aero/Iteration_test/04_TradeOff_StartingAEP/Results_1Chord_Twist.txt

 Chord  Twist 
0.2394 29.1208 
0.2308 27.7678 
0.2215 26.3086 
0.2118 24.8352 
0.2023 23.3994 
0.1931 22.0287 
0.1844 20.7364 
0.1761 19.5272 
0.1683 18.4008 
0.1610 17.3539 
0.1541 16.3822 
0.1477 15.4804 
0.1418 14.6431 
0.1362 13.8650 
0.1310 13.1413 
0.1262 12.4671 
0.1216 11.8382 
0.1174 11.2507 
0.1134 10.7011 
0.1096 10.1860
