Guiiem/TFG/06-Blade design/Aero/Iteration_test/Validation/360polar_cd.csv

Export File Created with QBlade v0.963 64bit on 24.09.2019 at 17:53:44
S1223_Imported_Polar_goodRe 360 V
Alpha [deg] | Cd
-1,80000e+02 | 1,87918e-29
-1,79000e+02 | 5,48256e-04
-1,78000e+02 | 2,19235e-03
-1,77000e+02 | 4,93029e-03
-1,76000e+02 | 8,75874e-03
-1,75000e+02 | 1,36730e-02
-1,74000e+02 | 1,96672e-02
-1,73000e+02 | 2,67338e-02
-1,72000e+02 | 3,48645e-02
-1,71000e+02 | 4,40491e-02
-1,70000e+02 | 5,42766e-02
-1,69000e+02 | 6,55345e-02
-1,68000e+02 | 7,78091e-02
-1,67000e+02 | 9,10854e-02
-1,66000e+02 | 1,05347e-01
-1,65000e+02 | 1,20577e-01
-1,64000e+02 | 1,36757e-01
-1,63000e+02 | 1,53866e-01
-1,62000e+02 | 1,71885e-01
-1,61000e+02 | 1,90790e-01
-1,60000e+02 | 2,10560e-01
-1,59000e+02 | 2,31170e-01
-1,58000e+02 | 2,52594e-01
-1,57000e+02 | 2,74807e-01
-1,56000e+02 | 2,97782e-01
-1,55000e+02 | 3,21491e-01
-1,54000e+02 | 3,45905e-01
-1,53000e+02 | 3,70993e-01
-1,52000e+02 | 3,96726e-01
-1,51000e+02 | 4,23073e-01
-1,50000e+02 | 4,50000e-01
-1,49000e+02 | 4,77476e-01
-1,48000e+02 | 5,05466e-01
-1,47000e+02 | 5,33937e-01
-1,46000e+02 | 5,62854e-01
-1,45000e+02 | 5,92182e-01
-1,44000e+02 | 6,21885e-01
-1,43000e+02 | 6,51926e-01
-1,42000e+02 | 6,82270e-01
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
