Guiiem/TFG/06-Blade design/Aero/Iteration_test/Validation/Cp_lambda_validation.csv

Export File Created with QBlade v0.963 64bit on 27.09.2019 at 17:19:02
Validation_newpolar_GoodRe Simulation Validation_newpolar_GoodRe Simulation TipLoss Validation_newpolar_GoodRe Simulation TipRootLoss
TSR | Cp | TSR | Cp | TSR | Cp
5,00000e-01 | 3,50181e-02 | 5,00000e-01 | 3,51051e-02 | 5,00000e-01 | 3,42067e-02
6,00000e-01 | 4,44646e-02 | 6,00000e-01 | 4,46486e-02 | 6,00000e-01 | 4,36211e-02
7,00000e-01 | 5,51664e-02 | 7,00000e-01 | 5,54792e-02 | 7,00000e-01 | 5,43409e-02
8,00000e-01 | 6,73413e-02 | 8,00000e-01 | 6,78357e-02 | 8,00000e-01 | 6,65820e-02
9,00000e-01 | 8,12221e-02 | 9,00000e-01 | 8,20241e-02 | 9,00000e-01 | 8,06751e-02
1,00000e+00 | 9,70618e-02 | 1,00000e+00 | 9,83286e-02 | 1,00000e+00 | 9,68648e-02
1,10000e+00 | 1,15150e-01 | 1,10000e+00 | 1,16903e-01 | 1,10000e+00 | 1,15343e-01
1,20000e+00 | 1,35813e-01 | 1,20000e+00 | 1,37961e-01 | 1,20000e+00 | 1,36297e-01
1,30000e+00 | 1,59438e-01 | 1,30000e+00 | 1,61591e-01 | 1,30000e+00 | 1,59899e-01
1,40000e+00 | 1,86501e-01 | 1,40000e+00 | 1,88166e-01 | 1,40000e+00 | 1,86344e-01
1,50000e+00 | 2,17612e-01 | 1,50000e+00 | 2,17866e-01 | 1,50000e+00 | 2,16030e-01
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
