Guiiem/TFG/01-Latex/Report/Images/Lambda_influence_axial_force-eps-converted-to.pdf

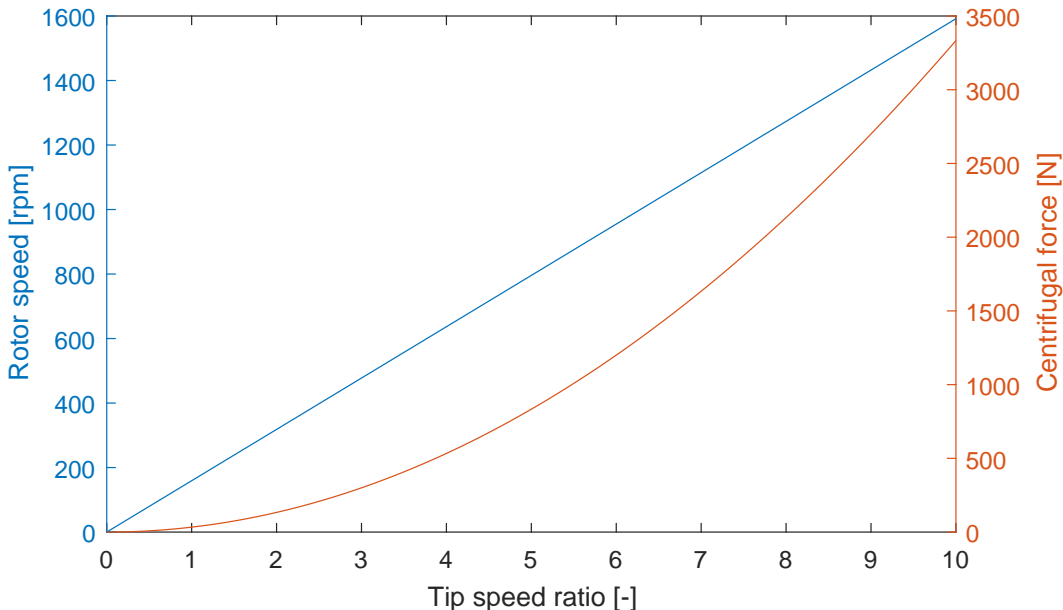
[picture p41: page 1]
Centrifugal force [N]

Rotor speed [rpm]

Tip speed ratio [-]
