Guiiem/TFG/01-Latex/Report/Images/Aerodynamic_Design/First_Operation_Results-eps-converted-to.pdf

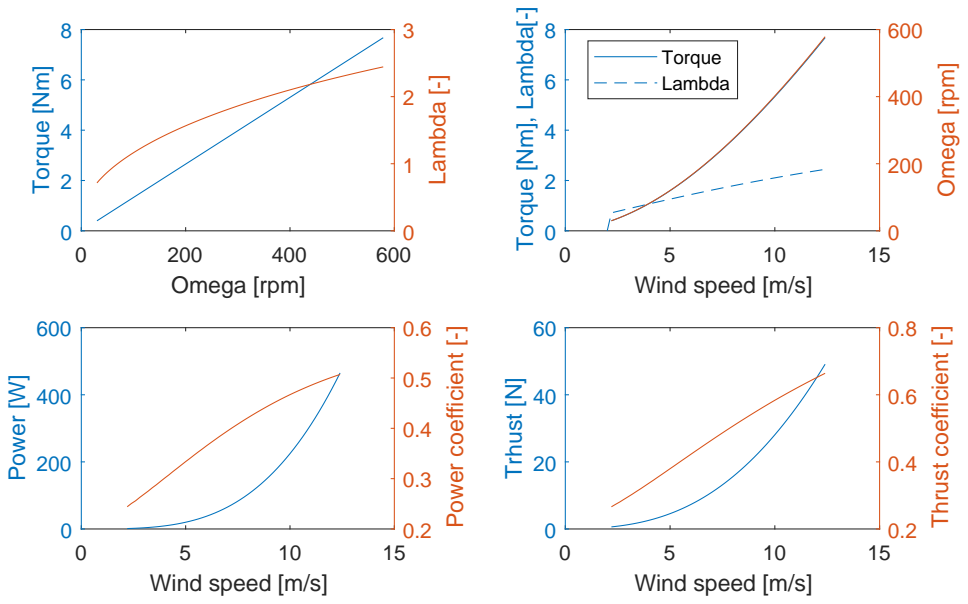
[picture p42: page 1]
Omega [rpm]; Torque [Nm]; Lambda [-]; Wind speed [m/s]; Torque Lambda; Power [W]; Power coefficient [-]; Trhust [N]; Thrust coefficient [-]

Torque [Nm], Lambda[-]
