Guiiem/TFG/01-Latex/Report/Images/Aerodynamic_Design/First_Polars_OpRegion-eps-converted-to.pdf

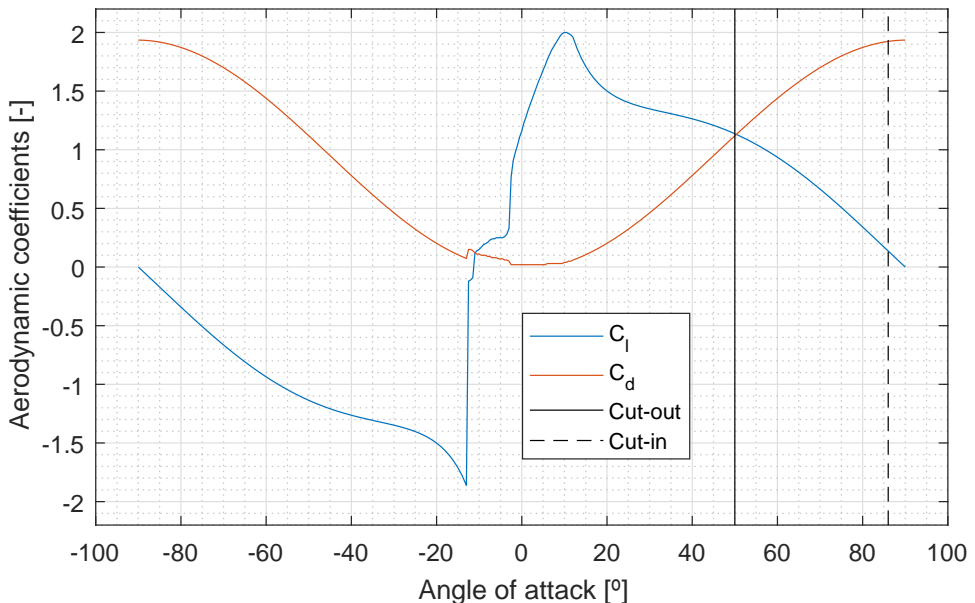
[picture p43: page 1]
Aerodynamic coefficients [-]; Cut-out Cut-in

Angle of attack [º]
