Guiiem/TFG/(commit log)

2019-05-20 Commit inicial
    [2_Base_pales.SLDPRT, 2_Base_pales.STL, 2_Coberta_motor.SLDPRT, 2_Coberta_motor.STL, 2_Pala_anemometre.SLDPRT, 2_Pala_anemometre.STL, 3_Base_pales.SLDPRT, 3_Base_pales.STL]
2019-05-25 Airfoil selection fins perfil 11
    [Airfoil_Selection.ods, Tasques.ods]
2019-06-09 Dades airfoils acabat
    [Airfoil_Selection.ods, S835_SW.csv]
2019-06-20 Inici Blade Design
    Encara esta airfoil selection amb el Cl posat com a parametre negatiu enlloc de positiu. Ara començo el disseny de les pales i canviaré això.
    [Airfoil_Selection.ods]
2019-07-02 Inici codi iteratiu BEMT amb corba generador
    [9-S1223 all points.ods, Airfoil_Selection.ods, Iterations.ods, Mesura_densitat_20_06_19.SLDPRT, Mesura_densitat_20_06_19.STL, T1_Re0.040_M0.00_N1.0.csv, T1_Re0.080_M0.00_N1.0.csv, T1_Re0.120_M0.00_N1.0.csv]
2019-09-13 13/09/19 - First Batch of the new Log
    Initial commit
    [1_Hub.SLDPRT, 2_Hub.SLDPRT, 3_Hub.SLDPRT, 3_Hub_stl_NonFinished_29_7_2019.STL, Airfoil_Selection.ods, Budget.ods, Generator_Selection_Options.ods, S1223.ods]
2019-09-17 17/09 inici validacio
    [9-S1223 all points.ods, Cp_lambda_validation.csv]
2019-09-27 27/09 - Codi de Hansen modificat amb QBlade codi font
    [360polar.csv, 360polar_cd.csv, 9-S1223 all points.ods, Cp_lambda_validation.csv]
